sirayuri/SPCC_BLDC/report/report.tex

% !TeX program = lualatex
\documentclass[twocolumn, a4paper, 10pt, fleqn]{ltjsarticle}

% --- パッケージ ---
\usepackage{luatexja-fontspec} % フォント設定用
\usepackage[top=20mm, bottom=20mm, left=18mm, right=18mm]{geometry}
\usepackage{graphicx}
\usepackage{amsmath,amssymb}
\usepackage{url}
\usepackage{here}
% \usepackage{flushend}
\usepackage{booktabs} % 表の罫線を太く・美しくする

% --- フォント設定 (LuaLaTeX用) ---
\usepackage{luatexja-fontspec} % これが必要

\usepackage{subcaption}
\captionsetup{compatibility=false} % ltjsarticleとの相性問題を回避するおまじない

% メインの日本語フォント（明朝）を設定
% BoldFont = MS Gothic とすることで、太字の時だけゴシックに切り替わる
\setmainjfont[
    BoldFont = MS Gothic
]{MS Mincho}

% \sffamily (サンセリフ体) も念のためMSゴシックにしておく
\setsansjfont{MS Gothic}

% --- レイアウト設定 ---
\setlength{\columnsep}{10mm}

% --- フォント設定（ここが重要） ---
% 1. 本文（メイン）の設定 -> 明朝 & Century
\setmainfont{Century}
\setmainjfont{MS Mincho}

% 2. ゴシック体・サンセリフの設定 -> MSゴシック & Arial
% ltjsarticleは、章タイトルに自動的にこの「サンセリフ/ゴシック」を使う仕様になっている
\setsansfont{Arial}
\setsansjfont{MS Gothic}

\usepackage{caption}

% labelsep = quad  --> コロンを消して「1文字分の空白(\quad)」を入れる
% labelsep = space --> コロンを消して「半角スペース」を入れる
\captionsetup{font=sf, labelsep=quad}

% --- タイトル情報 ---
\title{
    \vspace{-8.5mm} % ← ここ！ 数値はプレビュー見ながら調整して（-15mmとか）
    \sffamily 
    % タイトル：14pt (Word基準) / 行間 20pt くらいにしておく
    \fontsize{14bp}{20bp}\selectfont 
    SPCCを用いたブラシレスモーターの設計試作とトルク測定 \\[2mm]
    
    % 英語タイトル：少し小さくする指定がなければそのままでいいけど、一応12ptとかにする？
    \fontsize{14bp}{20bp}\selectfont 
    Design, Fabrication, and Torque Analysis of a Brushless DC Motor Using SPCC
}
\author{
\parbox{\textwidth}{% 1. ページ幅いっぱいの箱を作る
        \hfill % 2. これで中身を全力で右に押しやる
        % 3. ここに「左揃え(l)」の表を作る
        % @{} は表の左右の余計な隙間を消すおまじない
        \fontsize{10bp}{15bp}\selectfont
        \begin{tabular}{@{}l@{}} 
            ◯渡辺敦也(鳥羽商船高等専門学校，Atsuya WATANABE)※\\
            　児玉謙司(鳥羽商船高等専門学校，Kenji KODAMA)\\
            　宮崎孝(鳥羽商船高等専門学校，Takashi MIYAZAKI)
        \end{tabular}
    }%
}
\date{}

% --- 章・節タイトルの強制変更 (ゴシック10pt) ---
\makeatletter
% \section (1. はじめに) の設定
\renewcommand{\section}{\@startsection{section}{1}{\z@}%
    {1.0\Cvs \@plus.5\Cvs \@minus.2\Cvs}% 前の行間（少し狭めた）
    {.5\Cvs \@plus.3\Cvs}% 後の行間
    {\normalfont\sffamily\fontsize{10bp}{15bp}\selectfont}% ゴシック(sffamily) + 10pt
}

% --- 参考文献のスタイル変更 ---
% 1. リストの番号を [1] から 1) に変更
\renewcommand{\@biblabel}[1]{#1)}

\newcommand{\figref}[1]{\textsf{図\ref{#1}}}
\newcommand{\tabref}[1]{\textsf{表\ref{#1}}}

% 2. 本文中の参照（\cite）を右上の「1)」に変更
% もし「右上の小さい文字」にしたくない場合は \textsuperscript を外してね
\renewcommand{\@cite}[1]{\textsuperscript{#1)}}

% \subsection (2.1 実験方法) の設定
\renewcommand{\subsection}{\@startsection{subsection}{2}{\z@}%
    {1.0\Cvs \@plus.5\Cvs \@minus.2\Cvs}%
    {.5\Cvs \@plus.3\Cvs}%
    {\normalfont\sffamily\fontsize{10bp}{15bp}\selectfont}% ゴシック + 10pt
}
\makeatother

\makeatletter % ← これがないとエラーになるから絶対入れて！
\newcommand\blfootnote[1]{%
    \begingroup
    \renewcommand\thefootnote{}%
    % ▼ ここがポイント！
    % 「番号を入れるための枠」を破壊して、強制的に左詰め(\noindent)にする
    \renewcommand\@makefntext[1]{\noindent ##1}% 
    \footnote{#1}%
    \addtocounter{footnote}{-1}%
    \endgroup
}
\makeatother % ← これも忘れずに！

\pagestyle{empty} % ページ番号を消す（フッター領域も消える）
\linespread{0.85}
% --- 数式の左インデント設定 ---
% 3\zw = 全角文字(Zenkaku Width) 3つ分
\setlength{\mathindent}{3\zw}

\renewcommand{\footnotesize}{%  
    \fontsize{7.5bp}{10bp}\selectfont % 文字8pt / 行送り10pt
}
% --- 脚注の上の線をカラム幅いっぱいにする ---
\renewcommand{\footnoterule}{%
    \kern-3pt % 少し上に移動（デフォルト値）
    \hrule width \columnwidth height 0.4pt % 幅を段の幅(\columnwidth)にする
    \kern 2.6pt % 元の位置に戻す（デフォルト値）
}

% --- 本文開始 ---
\begin{document}

\maketitle

\blfootnote{日本設計工学会東海支部令和7年度研究発表講演会(2026年2月28日)}

% ▼ ここにマイナスのスペースを入れる！
% 数値はフォントサイズによるけど、だいたい -5mm ～ -8mm くらいで合うはず
\vspace{-7mm}

% ここから2段組
\section{はじめに}
近年，ロボット業界でブラシレスDCモーター(以下，BLDCモーター)を用いたアクチュエータの需要が高まっている．しかし，個人が日本国内で購入可能なBLDCモーターに限定すると選択肢が狭まり，使用用途に対してトルク・回転数等が要求仕様を大きく上回っていたり，サイズが合わない等の問題が起きる．\\
　このことから，プロジェクトに合った性能・サイズを持つBLDCモーターの製作が要求される．
ここで課題となるのが，ステータの材料である．一般的なBLDCモーターでは残留磁化・保磁力が極めて低く，高透磁率・低鉄損である電磁鋼板を用いることが多いが，小ロットでの入手が困難である．
本研究では性能では電磁鋼板には劣るものの，小ロットを安価に入手可能な材料であるSPCC(冷延鋼板)を用いてBLDCモーターのステータを設計・試作し，トルクを測定することで実用性を評価する．

\section{BLDCモーターの設計}
BLDCモーターには主にロータがコイルより内側にあるインナーロータ方式と，コイルより外側にあるアウターロータ方式の2種類が存在する．ロボット業界では出力トルクが大きいことや，関節に用いやすい形状であることから後者の方が需要が高い．
本研究では製作難易度とロボット業界での需要を踏まえ，アウターロータ方式のBLDCモーターを採用し，SolidWorksを用いて設計した．
設計したBLDCモーターの全体像を\textgt{\figref{fig:BLDC_all}}に示す．
\begin{figure}[H]
    \centering
    % --- (a) 左側の図 ---
    \begin{subfigure}[b]{0.48\linewidth}
        \centering
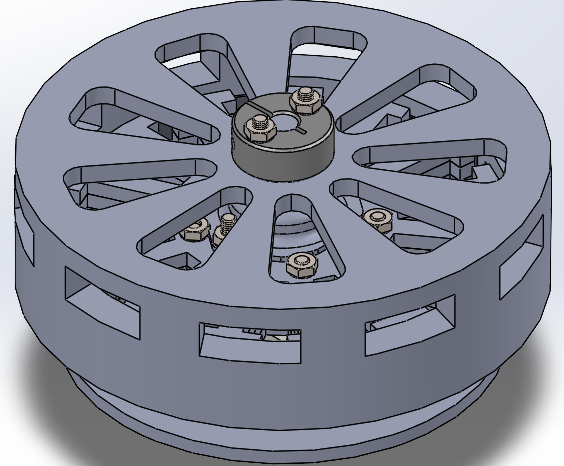
[picture p1: report/figure/BLDC_2.png]
        
        \caption{ロータ側}
        \label{fig:BLDC_top}
    \end{subfigure}
    \hfill % 左右の間隔を空ける
    % --- (b) 右側の図 ---
    \begin{subfigure}[b]{0.48\linewidth}
        \centering
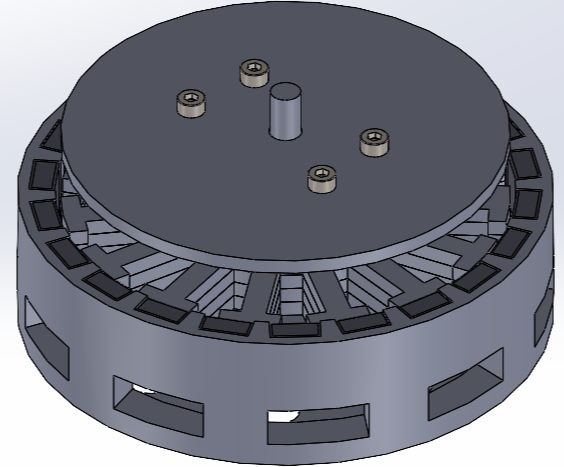
[picture p2: report/figure/BLDC_1.png]
        
        \caption{ステータ固定側}
        \label{fig:BLDC_bottom}
    \end{subfigure}
    % --- 全体のキャプション ---
    \caption{設計したBLDCモーター}
    \label{fig:BLDC_all}
\end{figure}

\vspace{-7mm}
\subsection{ステータの設計}
\vspace{-3mm}
ロボットアームやドローン用途に用いられる市販のアウターロータ方式のBLDCモーターの形状を参考に設計した．
これまでの検討では六角穴付きボルトを用いた9スロットのステータを設計したが，コギングトルクが非常に大きく，精密な制御が困難であった．スロット数を15に増やし，
材質を六角穴付きボルトの材質であるSCM435(クロムモリブデン鋼)からより軟磁性体に近いSPCC(冷延鋼板)に変更することでコギングトルクの低減が期待できる．\\
　SPCCをレーザー加工機で切り出し，断面を絶縁し4枚を重ね合わせ接着することで外径$88 \mathrm{mm}$のステータを構成する．このとき，レーザー加工機の加工限界を考慮し，厚さ3.2mmの薄板を用いる．
複数枚をそれぞれ絶縁して組み合わせることで，ステータ内部で発生する渦電流をある程度低減させ，発熱を抑える効果が多少期待できる．\\
　設計したステータを\textgt{\figref{fig:stater}}に示す．
\begin{figure}[H] % [tb]は「上(top)か下(bottom)に配置しろ」という指定
    \centering     % 図を中央寄せ
    % ▼ ここで画像を指定。[width=\linewidth]で段の幅ピッタリになる
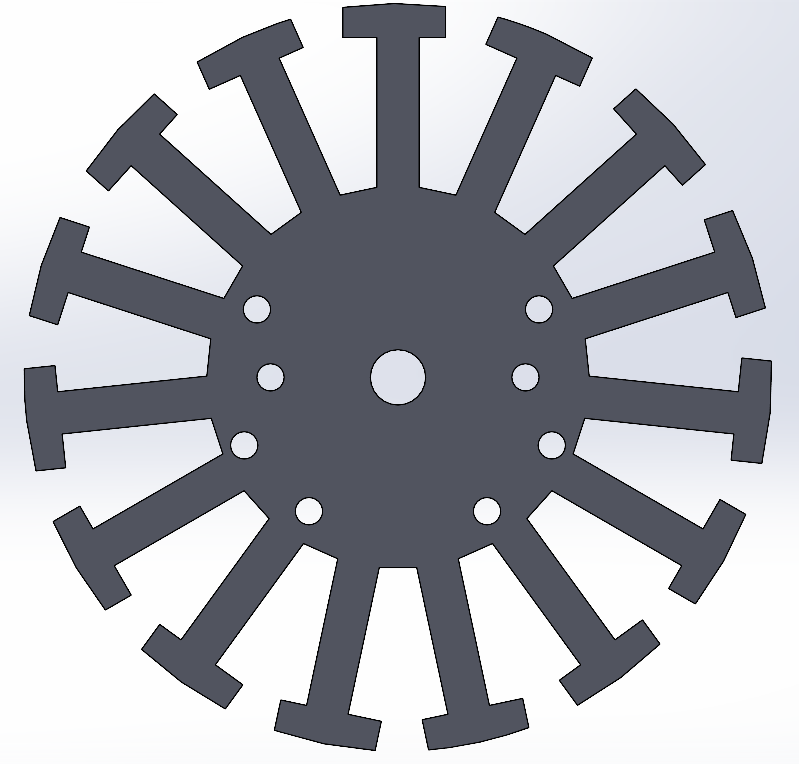
[picture p3: report/figure/stater.png]
     
    \caption{設計したステータ} % キャプションは図の下が一般的
    \label{fig:stater}            % 本文で参照するためのラベル
\end{figure}

\vspace{-7mm}
\subsection{ロータの設計}
\vspace{-3mm}
$12 \times 10 \times 5 \, (\mathrm{mm})$，表面磁束密度$B_{surf}$が$370(\mathrm{mT})$であるネオジム磁石を用いた外径$105 \mathrm{mm}$，内径$90 \mathrm{mm}$，極数22極のロータを設計した．
極数とスロット数の最小公倍数(LCM)は330であり，十分大きいため，コギングトルクの低減，出力トルクの向上が期待できる．\\
　ロータの慣性モーメントはBLDCモーターの性能に大きく影響を与える．ロータの材質をPLAとし，3Dプリンタで製造することで，質量を小さくし，慣性モーメントの低減を図る．\\
　アウターロータ方式のBLDCモーターは外部から空気が流入しないため，内部のコイルとステータの発熱が顕著になるという欠点がある．ロータに空気の流入口を設けることで冷却効果が期待できるよう設計した．\\
　設計したロータを\textgt{\figref{fig:rotor}}に示す．
\begin{figure}[H] % [tb]は「上(top)か下(bottom)に配置しろ」という指定
    \centering     % 図を中央寄せ
    % ▼ ここで画像を指定。[width=\linewidth]で段の幅ピッタリになる
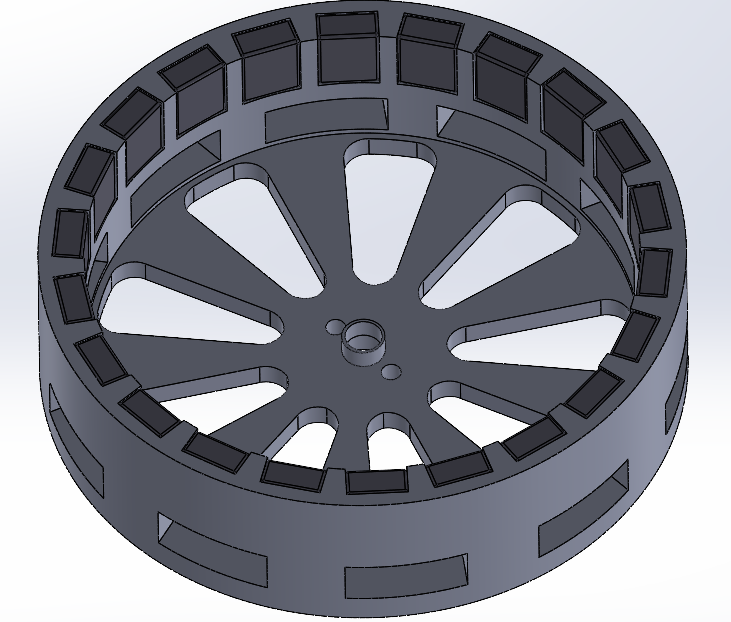
[picture p4: report/figure/rotor.png]
     
    \caption{設計したロータ} % キャプションは図の下が一般的
    \label{fig:rotor}            % 本文で参照するためのラベル
\end{figure}

\vspace{-7mm}
\section{トルクの推定}
\vspace{-3.5mm}
設計したBLDCモーターのトルクを計算して推定することで，理論値と実測値の乖離がどの程度大きくなるかを知ることができ，今後の設計に応用できる．
理論式を述べた後，各パラメータを代入してトルクを概算する．

\vspace{-5mm}
\subsection{トルクの理論式}
\vspace{-5.5mm}
表面磁石型のBLDCモーターのトルクの理論値を求める式は，極対数$P_n$，磁石による鎖交磁束$\Psi_a(\mathrm{Wb})$，磁石の作る磁束に直交する磁束を作る電流$I_q(\mathrm{A})$を用いると，次式で与えられる．
\begin{equation}
    T = \frac{3}{2} \cdot P_n \cdot \Psi_a \cdot I_q \label{eq:T_theoretical}
\end{equation}
この時，$\Psi_a(\mathrm{Wb})$は1スロットあたりのコイルの巻数$N$，巻線係数$k_w$，1極あたりのエアギャップの磁束密度$B_g(\mathrm{T})$，磁石の面積$S_g(\mathrm{m^2})$を用いて次式となる
\begin{equation}
    \Psi_a = N \cdot k_w \cdot B_g \cdot S_g \label{eq:Psi_a_theoretical}
\end{equation}
$B_g(\mathrm{T})$は磁石の残留磁束密度$B_r(\mathrm{T})$，エアギャップの距離$l_g(\mathrm{m})$，磁石の透磁率$\mu_r$，磁石の厚さ$l_m(\mathrm{m})$を用いて次式で表される
\begin{equation}
    B_g = \frac{B_r}{1+\frac{l_g \cdot \mu_r}{l_m}} \label{eq:B_g_theoretical}
\end{equation}

\vspace{-1mm}
\subsection{トルクの概算}
\vspace{-5.5mm}
式(\ref{eq:T_theoretical}),(\ref{eq:Psi_a_theoretical}),(\ref{eq:B_g_theoretical})に\textgt{\tabref{tab:motor_params}}に示すパラメータを代入し計算を行った結果，
\begin{equation}
    T \thickapprox 0.1767 \, (\mathrm{N \cdot m})
\end{equation}
という計算結果を得た．これをトルクの理論値として採用し，今後の比較に用いる．

\begin{table}[H]
    \centering
    \caption{設計したモーターの各パラメータ} % ★表のキャプションは「上」！
    \label{tab:motor_params}
    % 列指定: c=中央揃え, l=左揃え, r=右揃え
    % ここでは 記号(中央) | 意味(左) | 値(右) | 単位(左) にしてみた
    \begin{tabular}{clrl}
        \toprule % 上の太線
        記号 & パラメータ & \multicolumn{1}{c}{値} & 単位 \\ 
        \midrule % 中の細線
        $P_n$      & 極対数                 & 11   & - \\
        $I_q$      & $q$軸電流              & 1.000 & $\mathrm{A}$ \\
        $N$        & 1スロットのコイルの巻数 & 100   & - \\
        $k_w$      & 巻線係数               & 0.900  & - \\
        $S_g$      & 磁石1つの表面積           & 120.0   & $\mathrm{mm^2}$ \\
        $B_r$      & 磁石の残留磁束密度      & 1.200  & $\mathrm{T}$ \\
        $l_g$      & エアギャップ長         & 1.000& $\mathrm{mm}$ \\
        $\mu_r$    & 磁石の透磁率           & 1.050 & - \\
        $l_m$      & 磁石の厚さ             & 5.000& $\mathrm{mm}$ \\
        \bottomrule % 下の太線
    \end{tabular}
\end{table}

\vspace{-3.5mm}
\section{トルクの測定}
製作したモーターのトルク測定を行う．
\subsection{測定方法1（無負荷）}
\vspace{-3mm}
既知の慣性モーメント$J$を持つロータの角加速度$\dot{\omega}$を測定し，運動方程式 $T = J \cdot \dot{\omega}$ よりトルクを算出する．回転数ごとの動的なトルク特性を取得可能である．
\subsection{測定方法2（負荷あり）}
\vspace{-3mm}
長さ$l$のアームを取り付け，一定電流下で質量$m$の錘と釣り合わせることで静止トルクを測定する（$T = m \cdot g \cdot l$）．

\section{終わりに}
SPCC(冷延鋼板)を用いたステータと，PLAを用いたロータを設計・試作した．
ステータは3.2mm厚の板を絶縁して積層することで渦電流による発熱を抑え，ロータは慣性モーメントを小さくするために3Dプリンタ製パーツを採用した．
理論計算によるトルク推定を行った結果，減速機なしで$0.1767(\mathrm{N \cdot m})$となり，理論上は実用に足る性能であることがわかった．
講演では，設計製作したBLDCモーターの始動トルク，連続出力トルク，連続運転時の温度上昇の測定結果と，実際に実用に足る性能であったかを発表する．

\begin{thebibliography}{99}
    \bibitem{motor_book} R．Krishnan， Permanent Magnet Synchronous and Brushless DC Motors, CRC Press (2010), pp.7--9
\end{thebibliography}

\end{document}
