sirayuri/SPCC_BLDC/table/table.pdf

表 1: 設計したモーターの各パラメータ

記号 パラメータ | 値 | 単位
Pn | 極対数 | 11 -
qs | スロット数 | 15 -
N | 1 スロットのコイルの巻数 | 40 -
kw | 巻線係数 (仮定) | 0.900 -
Sg | 磁石 1 つの表面積 | 120.0 mm²
Br | 磁石の残留磁束密度 | 1.182 T
lg | エアギャップ長 | 2.000 mm
µr | 磁石の透磁率 | 1.050 -
lm | 磁石の厚さ | 5.000 mm

1
