sirayuri/SPCC_BLDC/report/figure/BLDC_3.png

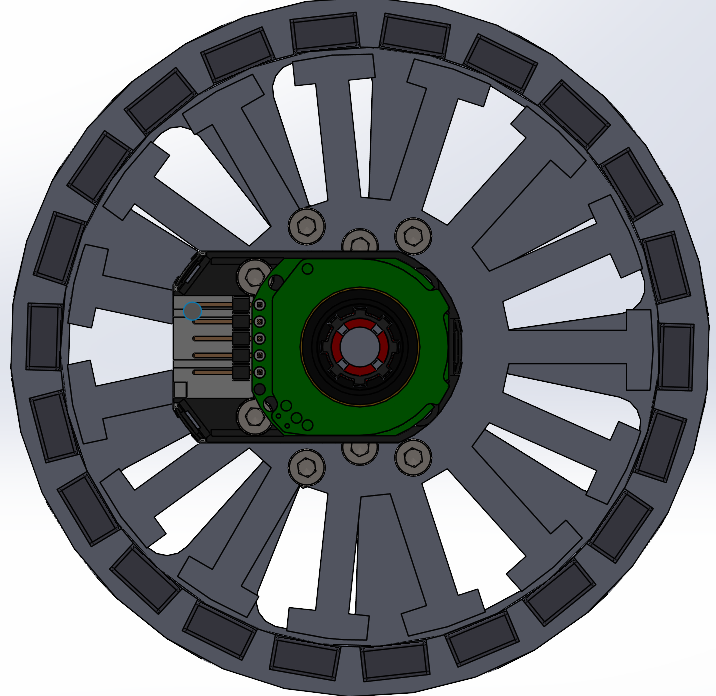
report/figure/BLDC_3.png
