sirayuri/SPCC_BLDC/report/figure/kiban.jpg

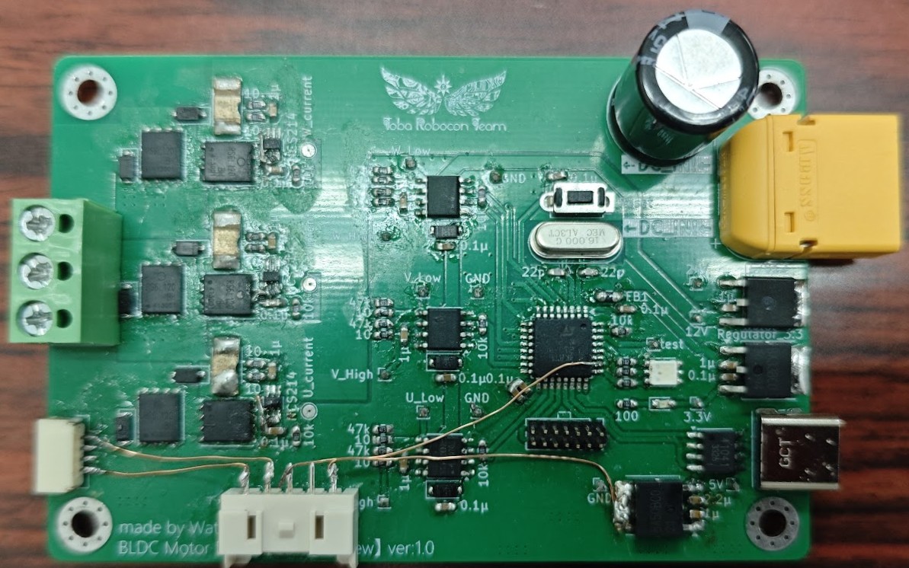
report/figure/kiban.jpg
