sirayuri/SPCC_BLDC/parts/Same_Sky_AMT10E2-0120-N6000-S/BOM.txt

3DX_Same_Sky_Supplier: Same Sky
3DX_Same_Sky_Description: AMT10E Series - 28 mm,  120 ~ 5120 PPR, Incremental, Capacitive Modular Encoder
3DX_Same_Sky_Model Number: AMT10E2-0120-N6000-S
