sirayuri/SPCC_BLDC/asen/rotor_next.SLDASM

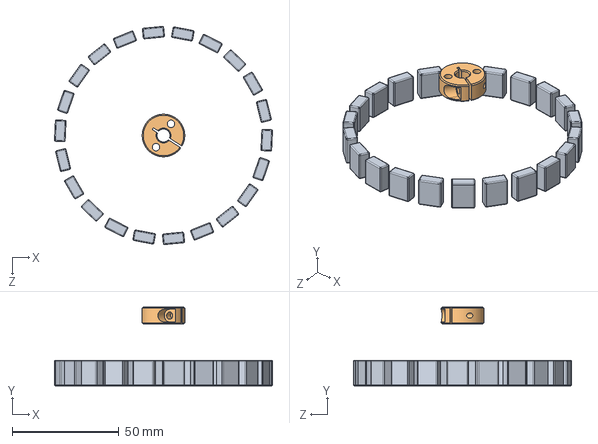
[picture p7: CAD file, 2026-03-08]
asen/rotor_next.SLDASM
102.3 x 37.0 x 102.4 mm
SCS 0608CP2-part
magnet x 22
