sirayuri/SPCC_BLDC/asen/main1.STEP

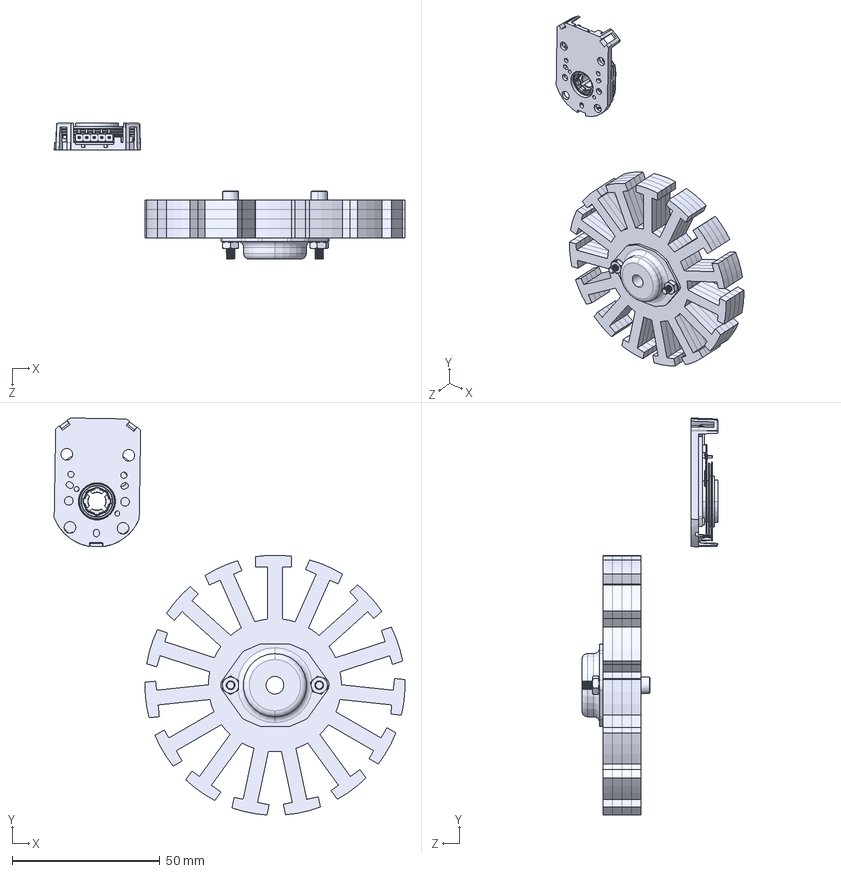
[picture p8: CAD file, 2026-02-08]
asen/main1.STEP
118.7 x 134.3 x 46.2 mm
3.2_stater x 4
6_bearing
AMT-102-Base-REV-K.step
AMT-102-Top-Cover-REV-I.step
AMT-Sleeve-REV-D_6 mm.step
AMT-Hub-Top-REV-D1.step
AMT-Hub-Bottom-REV-B.step
AMT10X-Shaft-Adaptor-REV-E.step
Receiver-board.step
Rotor-board-REV F.step
Transmitter-board AMT10_AMT-102.step
hexagon socket head cap screw_jis_JIS B 1176 M3 x 20 (20) --S x 2
hexagon nut style 1_ab_jis_JIS B 1181 Hexagon nut - style 1 A M3 - W --N x 2
