sirayuri/SPCC_BLDC/parts/IWATA_SCS0608CP2/SOLIDWORKS/SCS  0608CP2-part.sldprt

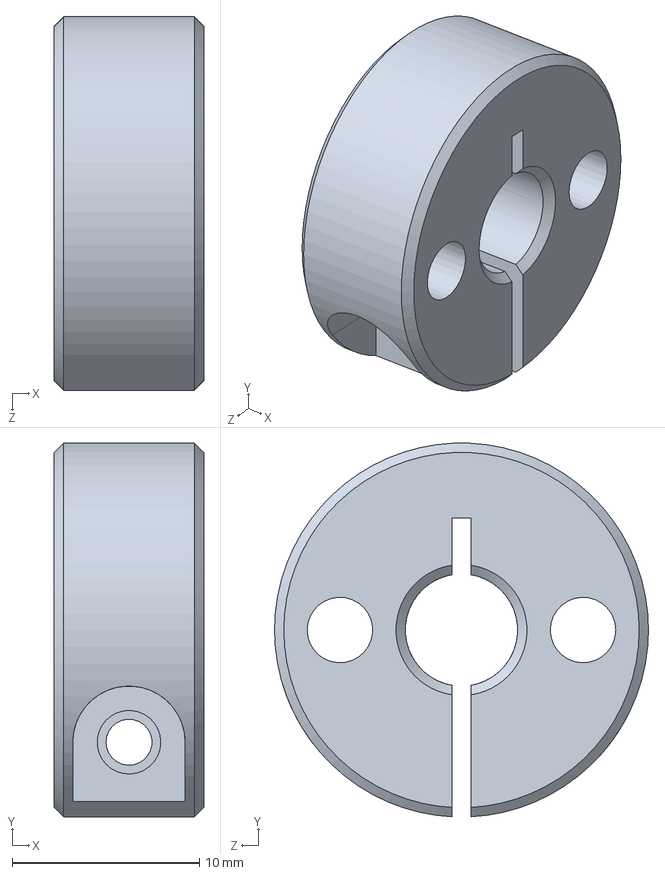
[picture p9: CAD file, 2026-02-24]
parts/IWATA_SCS0608CP2/SOLIDWORKS/SCS 0608CP2-part.sldprt
8.00 x 20.0 x 20.0 mm
