sirayuri/SPCC_BLDC/parts/Same_Sky_AMT10E2-0120-N6000-S/Same_Sky_AMT10E2-0120-N6000-S.step

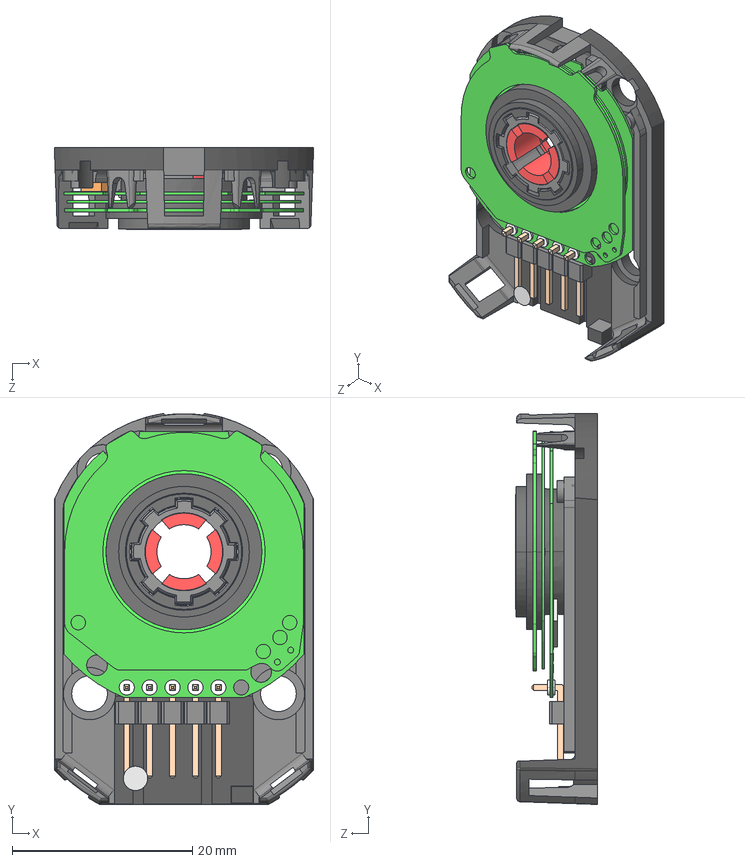
[picture p10: CAD file, 2026-02-08]
parts/Same_Sky_AMT10E2-0120-N6000-S/Same_Sky_AMT10E2-0120-N6000-S.step
28.8 x 43.4 x 9.15 mm
AMT-102-Base-REV-K
AMT-102-Top-Cover-REV-I
AMT-Sleeve-REV-D_6 mm
AMT-Hub-Top-REV-D1
AMT-Hub-Bottom-REV-B
AMT10X-Shaft-Adaptor-REV-E
Receiver-board
Rotor-board-REV F
Transmitter-board AMT10_AMT-102
