sirayuri/SPCC_BLDC/parts/Same_Sky_AMT10E2-D5120-N6000-W/Same_Sky_AMT10E2-D5120-N6000-W.step

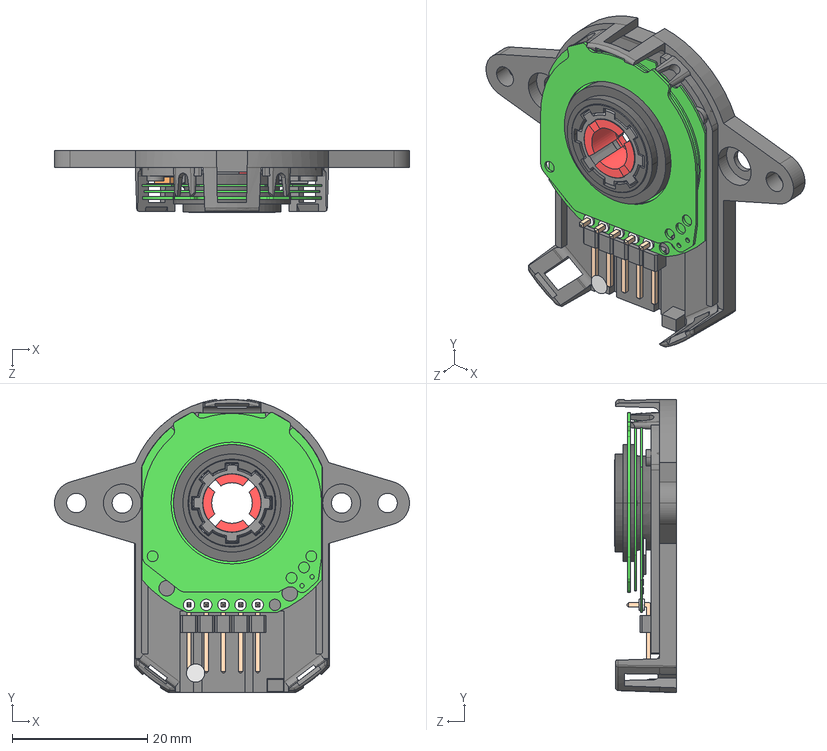
[picture p11: CAD file, 2026-02-07]
parts/Same_Sky_AMT10E2-D5120-N6000-W/Same_Sky_AMT10E2-D5120-N6000-W.step
52.5 x 43.4 x 9.15 mm
AMT-102-Top-Cover-REV-I
AMT-Sleeve-REV-D_6 mm
AMT-Hub-Top-REV-D1
AMT-Hub-Bottom-REV-B
AMT10X-Shaft-Adaptor-REV-E
Receiver-board
Rotor-board-REV F
Transmitter-board AMT10_AMT-102
AMT-102-Wide-Base-REV-J
