sirayuri/SPCC_BLDC/parts/ude.SLDPRT

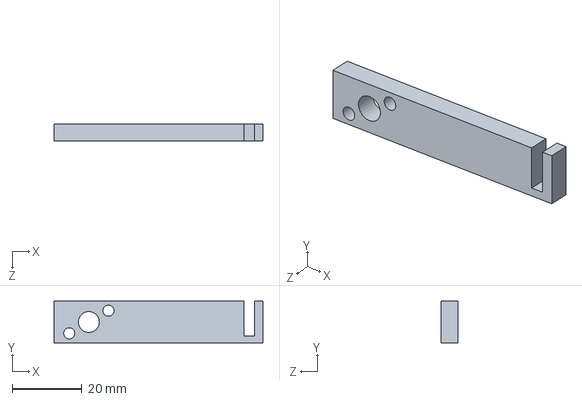
[picture p12: CAD file, 2026-03-08]
parts/ude.SLDPRT
60.0 x 12.0 x 5.00 mm
