sirayuri/SPCC_BLDC/parts/ziguzigu.SLDPRT

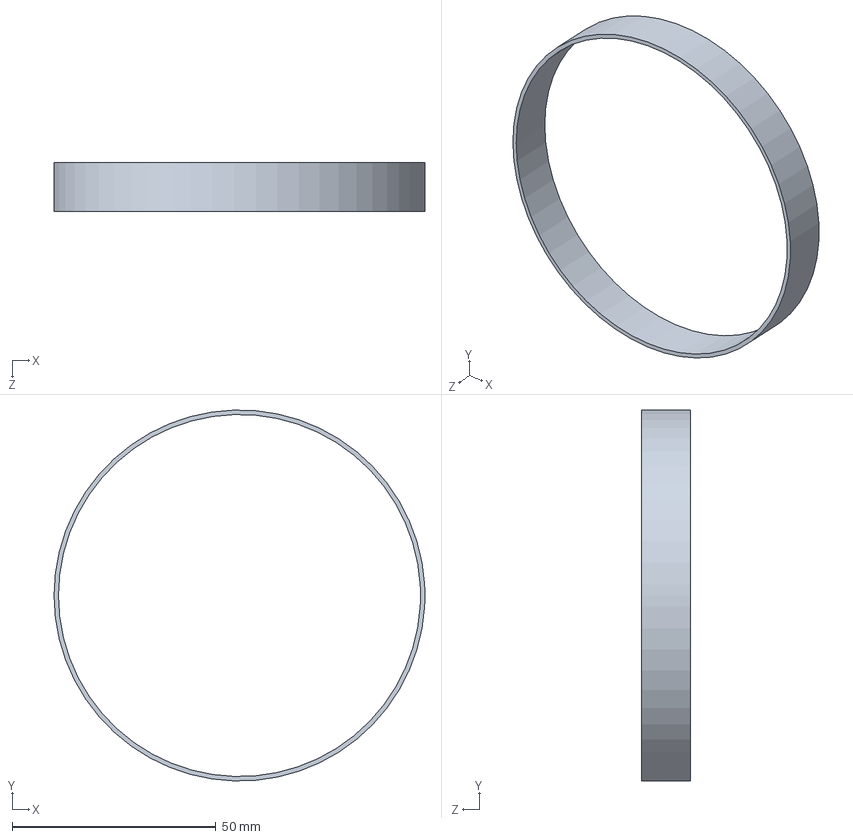
[picture p13: CAD file, 2026-02-27]
parts/ziguzigu.SLDPRT
91.0 x 91.0 x 12.0 mm
