sirayuri/SPCC_BLDC/parts/stater_cuber.STEP

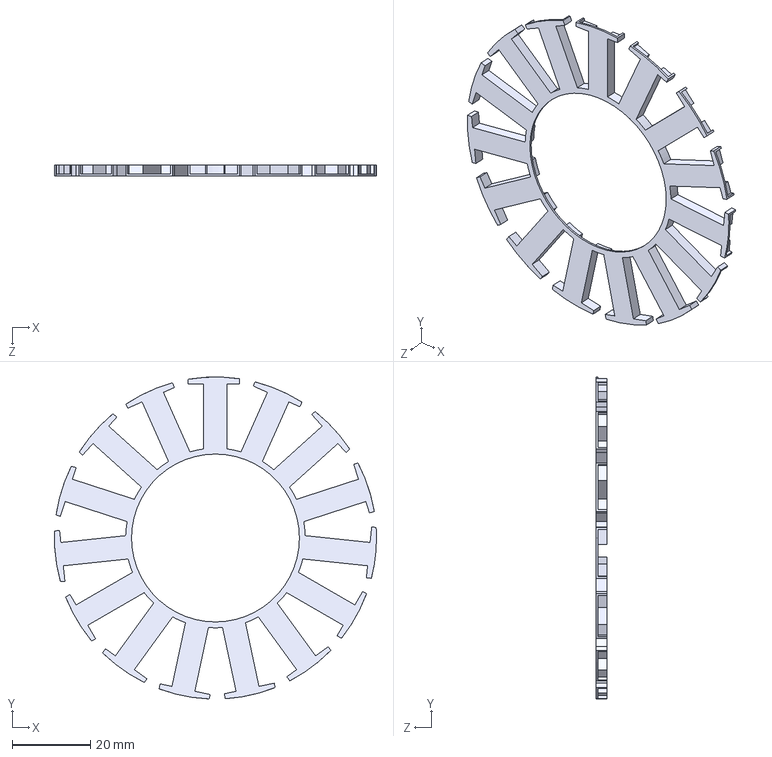
[picture p14: CAD file, 2026-02-23]
parts/stater_cuber.STEP
82.5 x 82.4 x 2.80 mm
