sirayuri/SPCC_BLDC/parts/roter_next_next_next.STEP

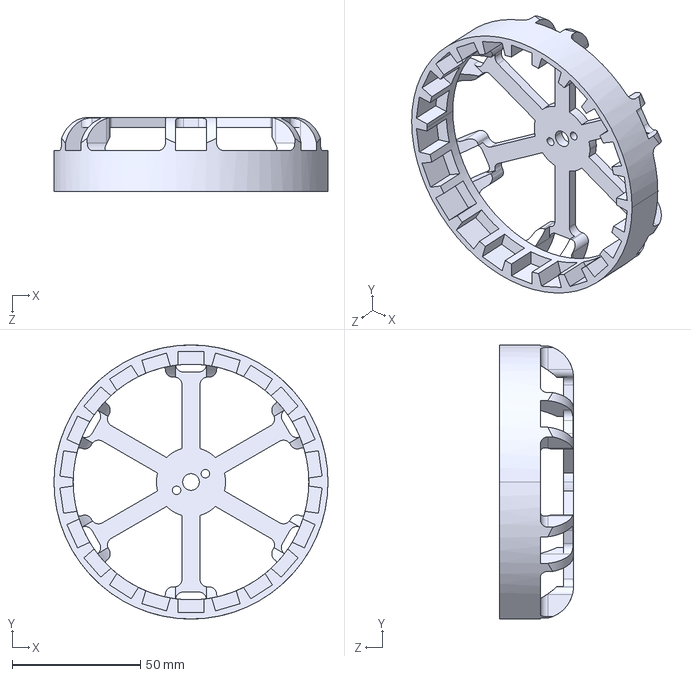
[picture p15: CAD file, 2026-02-23]
parts/roter_next_next_next.STEP
107.0 x 107.0 x 29.0 mm
