sirayuri/SPCC_BLDC/parts/tateruyatu.SLDPRT

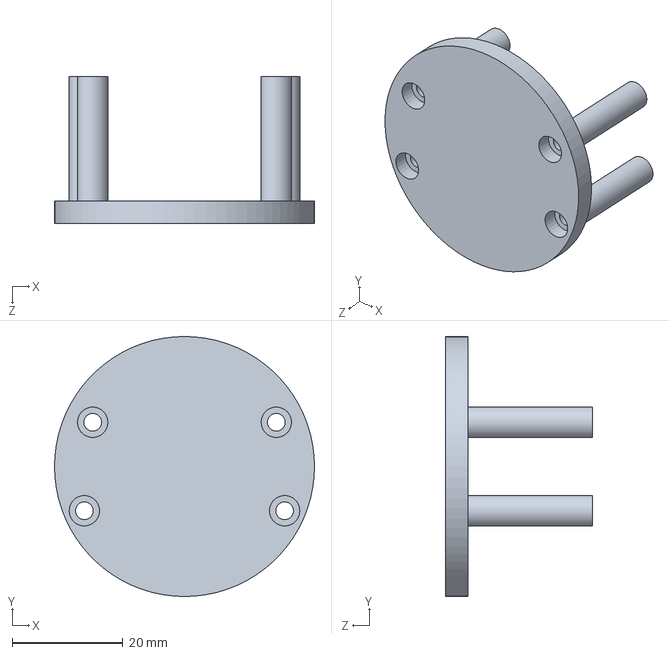
[picture p16: CAD file, 2026-02-23]
parts/tateruyatu.SLDPRT
47.0 x 47.0 x 26.5 mm
