sirayuri/SPCC_BLDC/parts/cuba-.SLDPRT

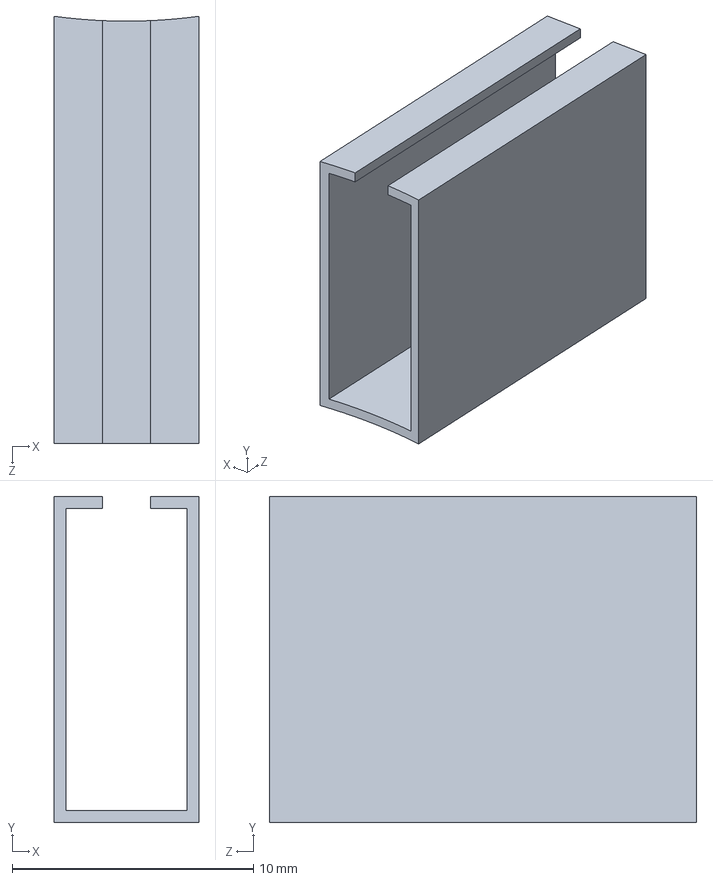
[picture p17: CAD file, 2026-02-23]
parts/cuba-.SLDPRT
6.00 x 13.5 x 17.7 mm
