sirayuri/SPCC_BLDC/parts/stater_cuber_ura.STEP

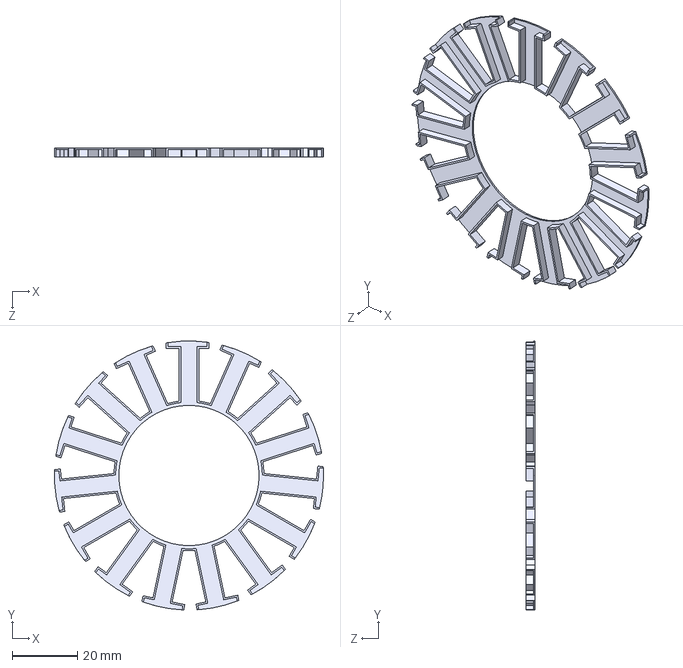
[picture p18: CAD file, 2026-02-23]
parts/stater_cuber_ura.STEP
82.5 x 82.4 x 2.80 mm
