sirayuri/SPCC_BLDC/parts/egusupacer.SLDPRT

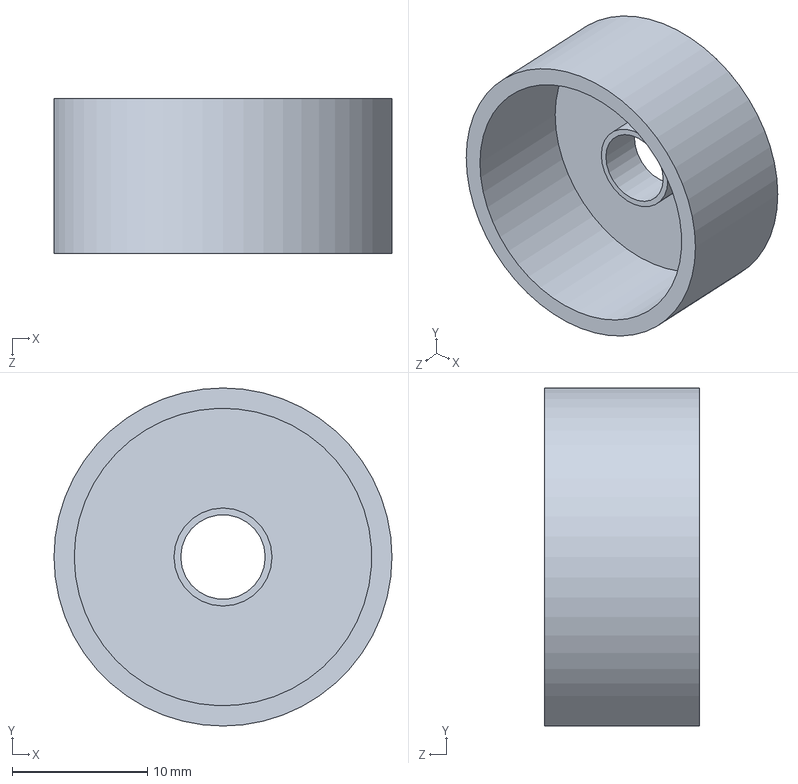
[picture p19: CAD file, 2026-02-19]
parts/egusupacer.SLDPRT
25.0 x 25.0 x 11.5 mm
