sirayuri/SPCC_BLDC/parts/tyouseiyou.SLDPRT

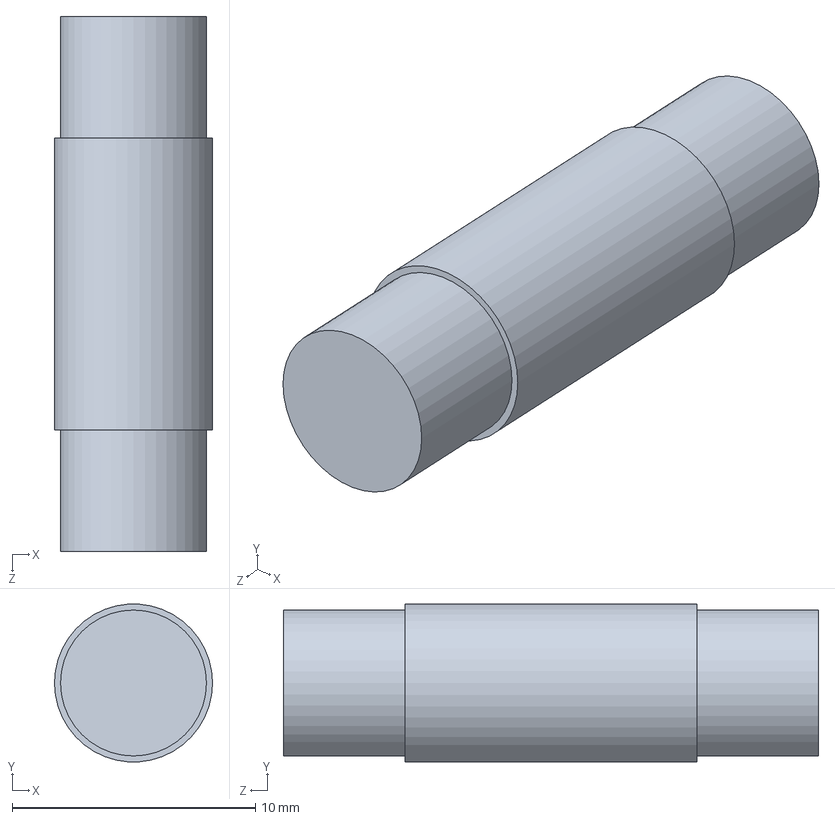
[picture p20: CAD file, 2026-02-19]
parts/tyouseiyou.SLDPRT
6.50 x 6.48 x 22.0 mm
