sirayuri/SPCC_BLDC/parts/saft_spacer.SLDPRT

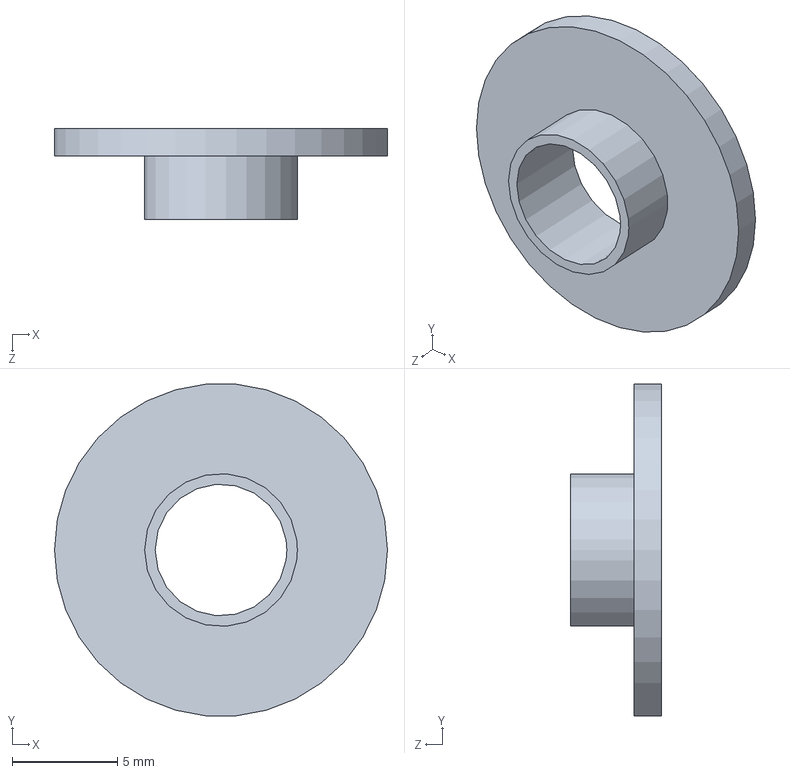
[picture p21: CAD file, 2026-02-18]
parts/saft_spacer.SLDPRT
15.8 x 15.7 x 4.30 mm
