sirayuri/SPCC_BLDC/parts/spacer_7.2.SLDPRT

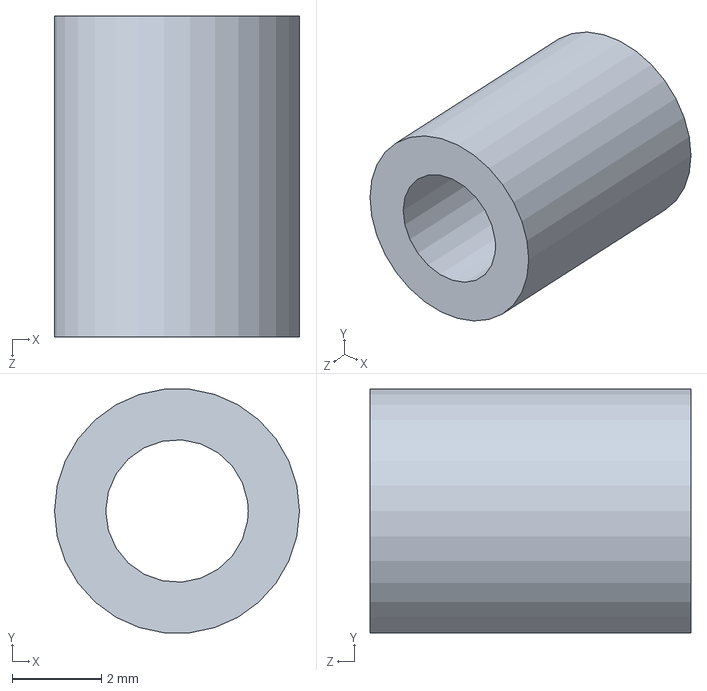
[picture p22: CAD file, 2026-02-18]
parts/spacer_7.2.SLDPRT
5.50 x 5.47 x 7.20 mm
