sirayuri/SPCC_BLDC/parts/spacer_16.2.SLDPRT

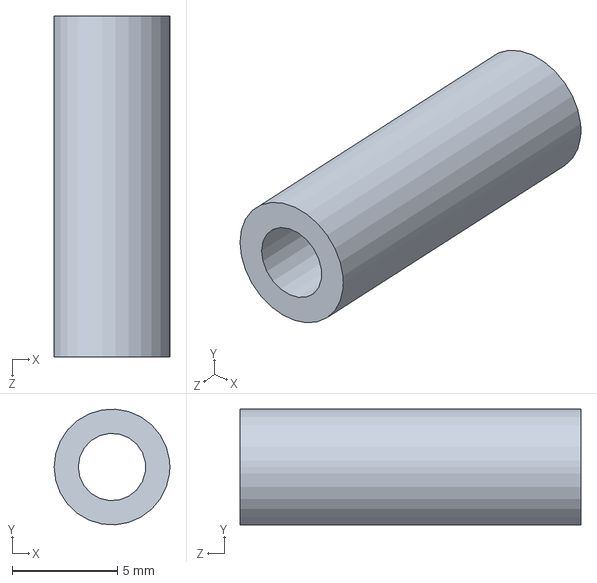
[picture p23: CAD file, 2026-02-18]
parts/spacer_16.2.SLDPRT
5.50 x 5.49 x 16.2 mm
