sirayuri/SPCC_BLDC/parts/hari.SLDPRT

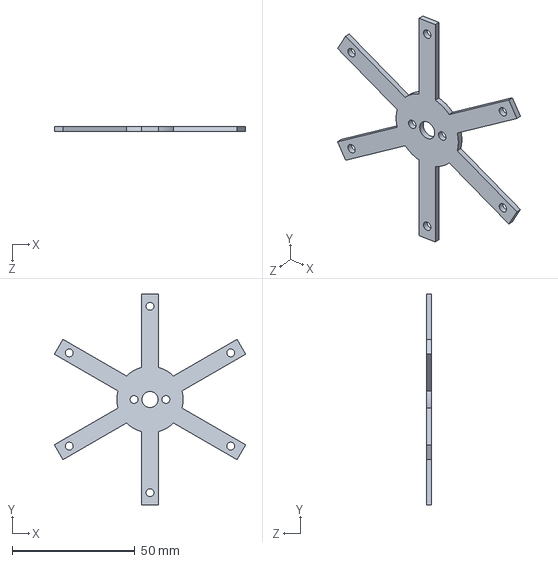
[picture p24: CAD file, 2026-02-18]
parts/hari.SLDPRT
77.9 x 85.9 x 2.00 mm
