sirayuri/SPCC_BLDC/parts/spacer_3_5.STEP

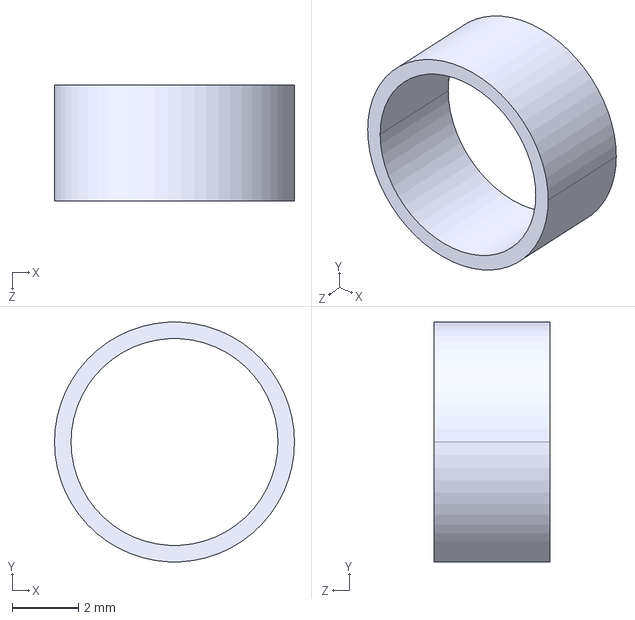
[picture p25: CAD file, 2026-02-17]
parts/spacer_3_5.STEP
7.25 x 7.24 x 3.50 mm
