sirayuri/SPCC_BLDC/parts/spacer_12.5.STEP

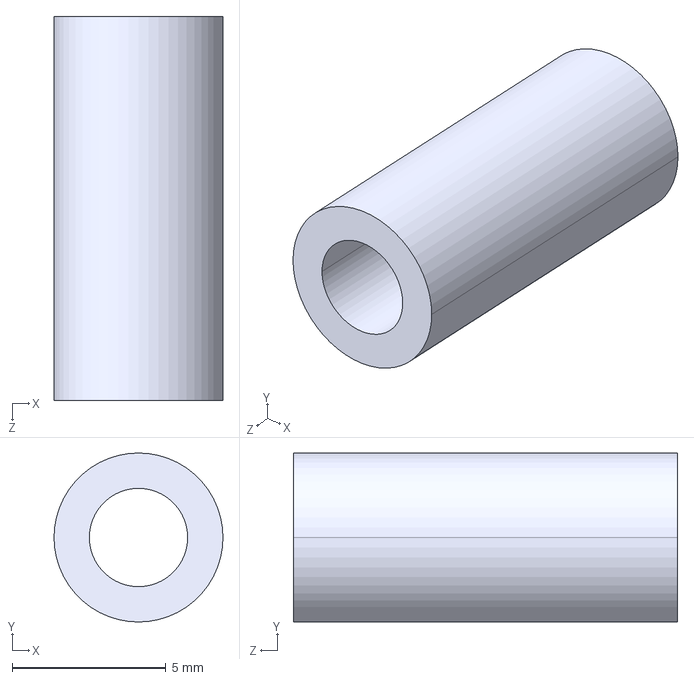
[picture p26: CAD file, 2026-02-17]
parts/spacer_12.5.STEP
5.50 x 5.50 x 12.5 mm
