sirayuri/SPCC_BLDC/parts/spacer_3.STEP

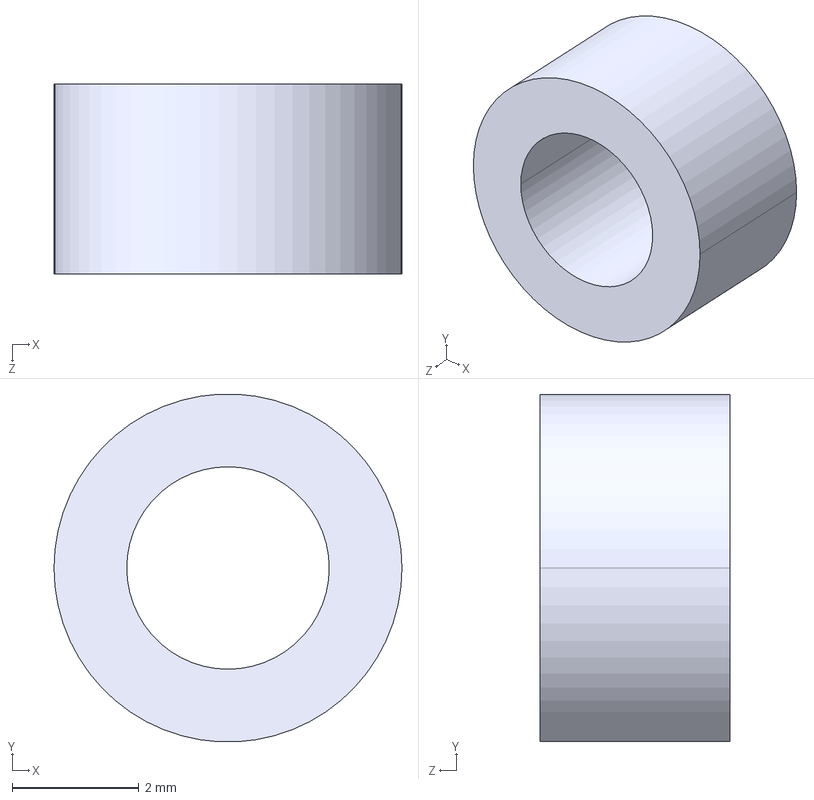
[picture p27: CAD file, 2026-02-17]
parts/spacer_3.STEP
5.50 x 5.49 x 3.00 mm
