sirayuri/SPCC_BLDC/parts/roter_next.STEP

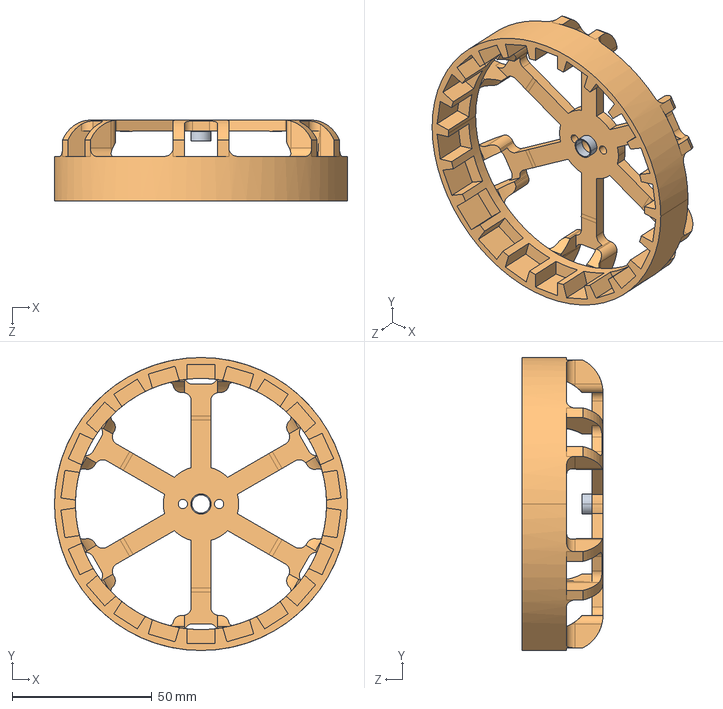
[picture p28: CAD file, 2026-02-15]
parts/roter_next.STEP
105.0 x 105.0 x 29.0 mm
