sirayuri/SPCC_BLDC/parts/magnet.SLDPRT

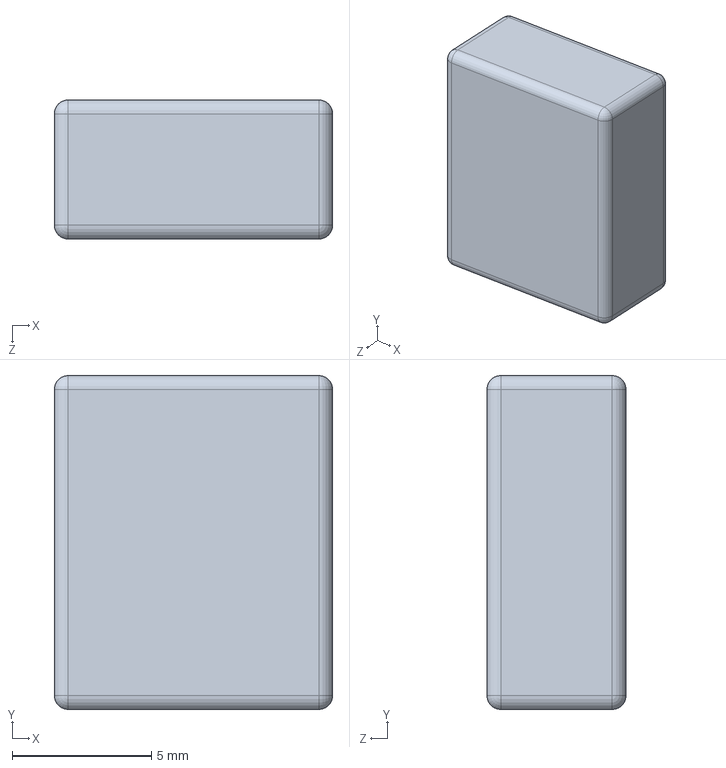
[picture p29: CAD file, 2026-02-15]
parts/magnet.SLDPRT
10.0 x 12.0 x 5.00 mm
