sirayuri/SPCC_BLDC/parts/plate.SLDPRT

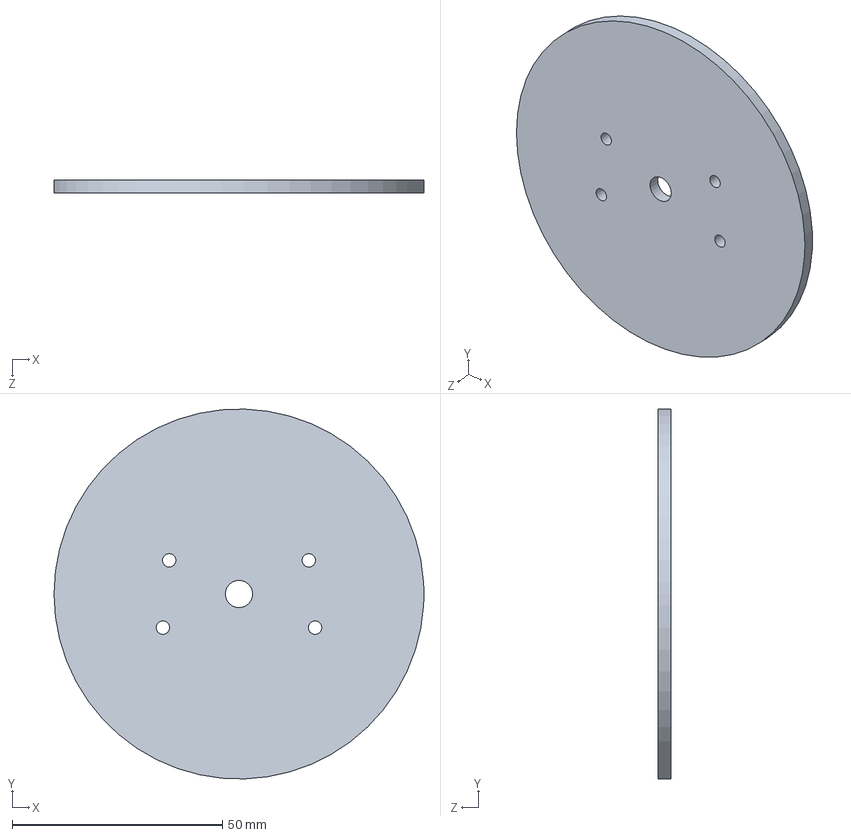
[picture p30: CAD file, 2026-02-15]
parts/plate.SLDPRT
88.0 x 88.0 x 3.00 mm
