sirayuri/SPCC_BLDC/parts/roter.STEP

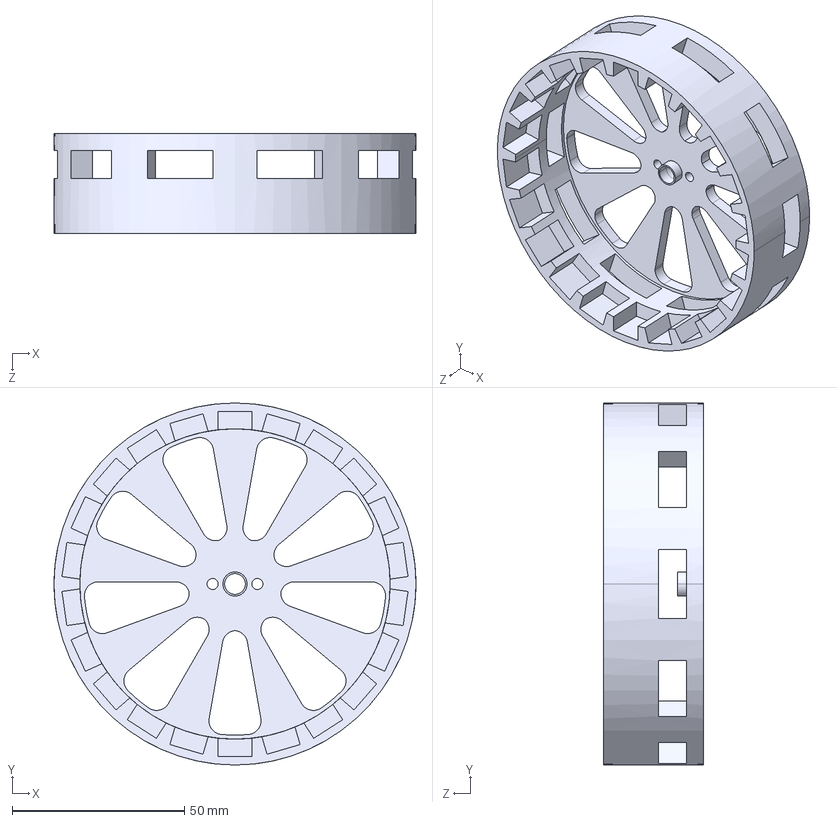
[picture p31: CAD file, 2026-02-11]
parts/roter.STEP
105.0 x 105.0 x 29.0 mm
