sirayuri/SPCC_BLDC/parts/shaft_6.STEP

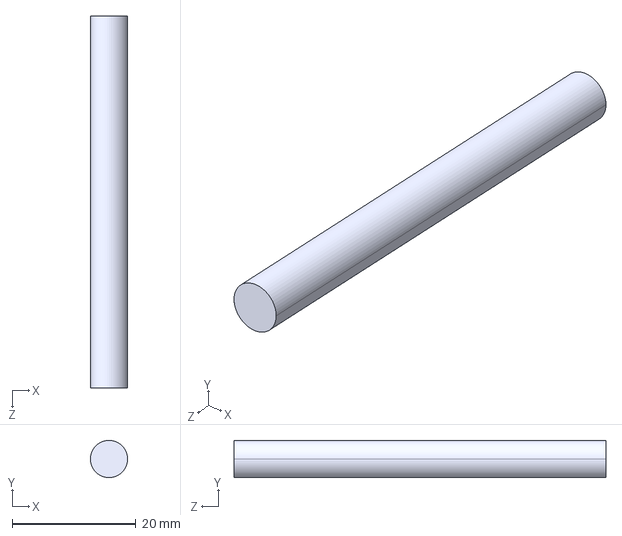
[picture p32: CAD file, 2026-02-08]
parts/shaft_6.STEP
6.00 x 6.00 x 60.0 mm
