sirayuri/SPCC_BLDC/parts/3.2_stater.STEP

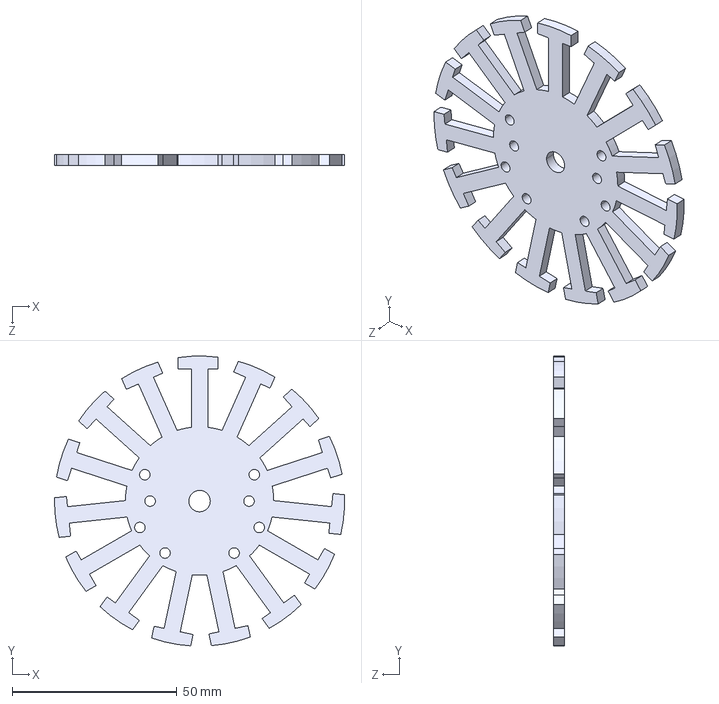
[picture p33: CAD file, 2026-02-08]
parts/3.2_stater.STEP
88.0 x 87.9 x 3.20 mm
