sirayuri/SPCC_BLDC/parts/6_bearing.SLDPRT

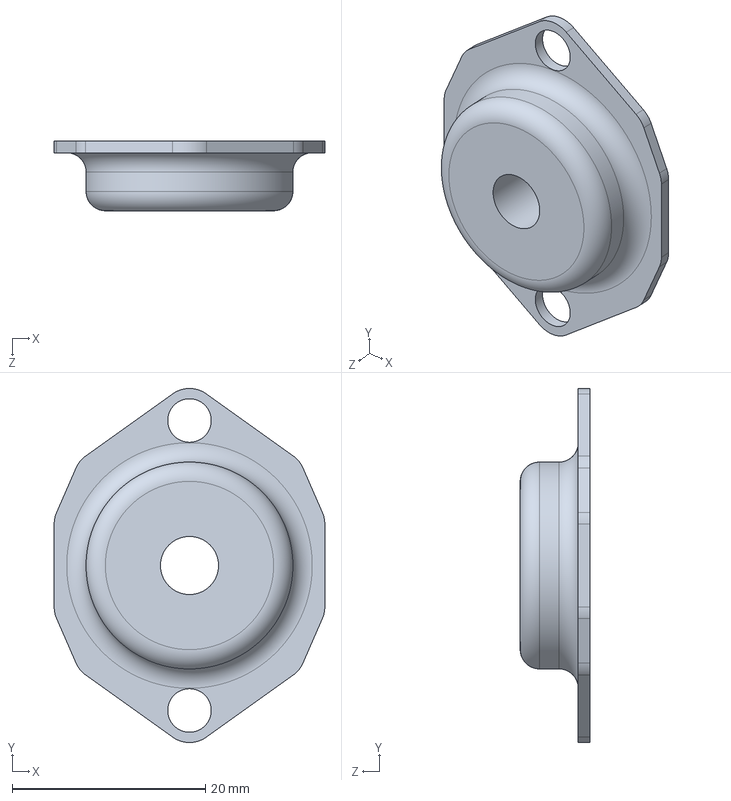
[picture p34: CAD file, 2026-02-07]
parts/6_bearing.SLDPRT
28.0 x 36.6 x 7.20 mm
