sirayuri/SPCC_BLDC/asen/rotor.SLDASM

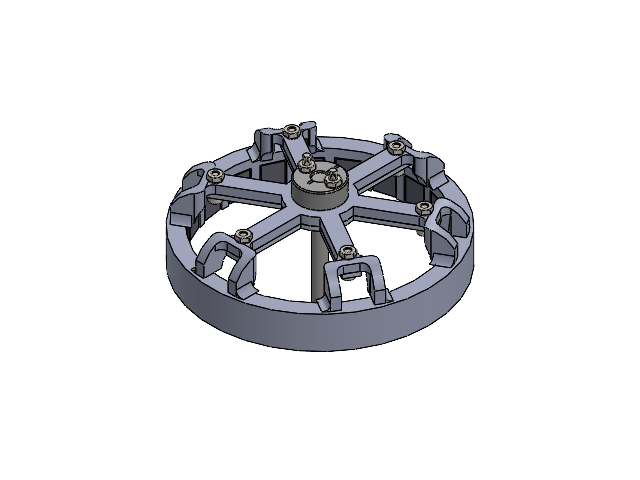
[picture p35: CAD file, 2026-02-23]
asen/rotor.SLDASM
roter_next_next
magnet x 22
SCS 0608CP2-part
shaft_6
hari
hexagon socket head cap screw_jis x 8
hexagon nut style 1_ab_jis x 8
