sirayuri/SPCC_BLDC/asen/stater.SLDASM

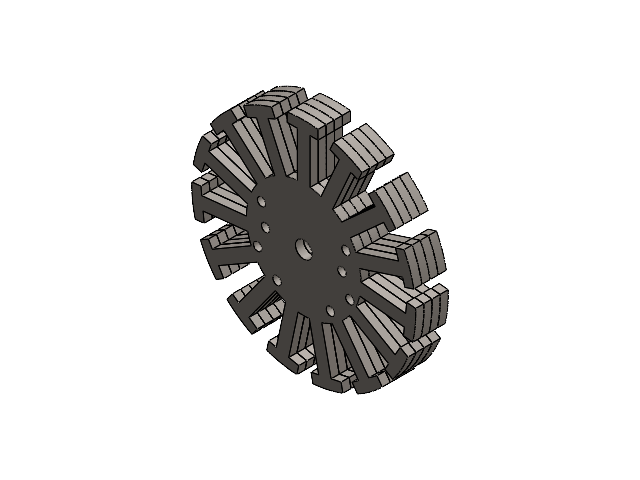
[picture p36: CAD file, 2026-02-17]
asen/stater.SLDASM
3.2_stater x 4
