sirayuri/SPCC_BLDC/(list of files, cad)

Other CAD files:
parts/IWATA_SCS0608CP2/SOLIDWORKS/SCS0608CP2.sldasm
parts/roter_next_next.SLDPRT
3.2_stater.3mf
3.2_stater.STEP
asen/main1.SLDASM
parts/3.2_stater.DXF
parts/3.2_stater.SLDPRT
parts/cuba-.STL
parts/egusupacer.STL
parts/hexagon socket head cap screw_jis.SLDPRT
parts/roter.3mf
parts/roter.SLDPRT
parts/roter_next.SLDPRT
parts/roter_next_next.STL
parts/roter_next_next_next.SLDPRT
parts/saft_spacer.STL
parts/shaft_6.SLDPRT
parts/spacer_12.5.SLDPRT
parts/spacer_3.3mf
parts/spacer_3.SLDPRT
parts/spacer_3_5.SLDPRT
parts/spacer_7.2.STL
parts/stater_cuber.3mf
parts/stater_cuber.SLDPRT
parts/stater_cuber_ura.SLDPRT
parts/tateruyatu.3mf
parts/tateruyatu.STL
parts/tyouseiyou.STL
parts/ude.STL
parts/ziguzigu.STL
