sirayuri/SPCC_BLDC/programs/SPCC_BLDC_FOC_dq_FF/Core/Src/main.c

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
/* Includes ------------------------------------------------------------------*/
#include "main.h"

/* USER CODE BEGIN Includes */

#include <stdio.h>
#include <math.h>
#include <stdbool.h>

/* USER CODE END Includes */

/* USER CODE BEGIN PTD */

typedef struct{
	float kp;
	float ki;
	float goal;
	float now_value;
	float error;
	float error_integral;
	float error_integral_temp;
	float integral_limit;
}PI_t;

typedef struct{
	float kp;
	float ki;
	float kd;
	float goal;
	float now_value;
	float error;
	float error_old;
	float error_integral;
	float error_integral_temp;
	float integral_limit;
}PID_t;

/* USER CODE END PTD */

/* USER CODE BEGIN PM */

//PWMの使用タイマ
#define MOTOR_PWM_TIMER htim3
//各チャンネル
#define U_PHASE_PWM_CHANNEL TIM_CHANNEL_3
#define V_PHASE_PWM_CHANNEL TIM_CHANNEL_2
#define W_PHASE_PWM_CHANNEL TIM_CHANNEL_1

//PWM出力関数
#define SET_PWM_DUTY(PHASE, DUTY) __HAL_TIM_SET_COMPARE(&MOTOR_PWM_TIMER, PHASE##_PHASE_PWM_CHANNEL, DUTY)

#define SQRT3_OVER_2 0.8660254f
#define ONE_OVER_SQRT3 0.57735026f
#define PI 3.1415f

/* USER CODE END PM */

ADC_HandleTypeDef hadc1;
DMA_HandleTypeDef hdma_adc1;

TIM_HandleTypeDef htim1;
TIM_HandleTypeDef htim2;
TIM_HandleTypeDef htim3;

UART_HandleTypeDef huart1;

/* USER CODE BEGIN PV */

/*	モーターの定数	*/
//極対数
int pole_pairs = 11;

/*	角度関係	*/
//現在のエンコーダーのカウント
uint16_t cnt_now = 0;

//1回前のエンコーダーのカウント
uint16_t cnt_old = 0;

//回転した回数
int revolution_count = 0;

//エンコーダーが1回のループでどれだけ回転したら1回転したとみなすかのしきい値
int revolution_threshold_num = 10000;

//現在のラジアン角
float degree = 0;

//現在のラジアン機械角
float degree_e = 0;

//機械角に対するsin,cos
float degree_e_sin = 0;
float degree_e_cos = 0;

/*	電流センシング関係	   */

//DMAから送られてくる生のDMAの値
volatile uint16_t adc_raw[3] = {0};

//モーター停止時の電流センサにかかるオフセット電圧
int adc_offset[3] = {0};

//オフセットの平均値の計算に使用
int offset_count = 0;
int offset_ave_num = 30;
volatile bool offset_done_flag = false;

//現在の電流値
volatile float I_u = 0;
volatile float I_v = 0;
volatile float I_w = 0;

//電流の総和
float I_sum = 0;

/* ベクトル制御用変数 */
//dq電流
float Id = 0.0;
float Iq = 0.0;

//αβ電流
float Ia = 0.0;
float Ib = 0.0;

//dq電圧
float Vd = 0.0;
float Vq = 0.0;

//αβ電圧
float Va = 0.0;
float Vb = 0.0;

//PWM
int U_PWM = 0;
int V_PWM = 0;
int W_PWM = 0;

int Amp_PWM_MAX = 300;

//PI制御用構造体
PI_t Id_PI;
PI_t Iq_PI;

volatile bool tim1_flag = false;
volatile bool tim3_flag = false;
volatile bool zero_set_flag = false;

//ログ用
#define LOG_SIZE 500
float dq_log[2][LOG_SIZE] = {0};
int log_index = 0;
int log_prescaler = 0;
volatile bool logging_active = false;


/*	位置PID用変数	*/
PID_t Place_PID;

float test_theta = 0.0;

/* USER CODE END PV */

void SystemClock_Config(void);
static void MX_GPIO_Init(void);
static void MX_DMA_Init(void);
static void MX_ADC1_Init(void);
static void MX_TIM3_Init(void);
static void MX_USART1_UART_Init(void);
static void MX_TIM2_Init(void);
static void MX_TIM1_Init(void);
/* USER CODE BEGIN PFP */
int constrain(int num, int min, int max);
float constrainf(float num, float min, float max);
int _write(int file, char *ptr, int len);
void clarke_transform(void);
void park_transform(void);
void inv_clarke_transform(void);
void inv_park_transform(void);
float PI_Control(PI_t *hPI);
/* USER CODE END PFP */

/* USER CODE BEGIN 0 */

int constrain(int num, int min, int max){
	if(num > max){
		return max;
	}
	else if(min > num){
		return min;
	}
	else{
		return num;
	}
}

float constrainf(float num, float min, float max){
	if(num > max){
		return max;
	}
	else if(min > num){
		return min;
	}
	else{
		return num;
	}
}

//printfおまじない
int _write(int file, char *ptr, int len)
{
  HAL_UART_Transmit(&huart1,(uint8_t *)ptr,len,10);
  return len;
}

void HAL_TIM_PeriodElapsedCallback(TIM_HandleTypeDef *htim)
{
    if(htim == &htim1){
    	tim1_flag = true;
    }

    if(htim == &htim3){
    	tim3_flag = true;
    }
}

//ADCのDAM割り込み！
void HAL_ADC_ConvCpltCallback(ADC_HandleTypeDef* hadc)
{
    if (hadc->Instance == ADC1 && !zero_set_flag) {
    	if(__HAL_TIM_GET_COUNTER(&htim3) < 500){
        	//オフセット検出モードか、電流センシングモードか
        	if(offset_done_flag == false){
        		adc_offset[0] += adc_raw[0];
        		adc_offset[1] += adc_raw[1];
        		adc_offset[2] += adc_raw[2];

        		offset_count++;

        		if(offset_count >= offset_ave_num){
    				adc_offset[0] = adc_offset[0] / offset_ave_num;
    				adc_offset[1] = adc_offset[1] / offset_ave_num;
    				adc_offset[2] = adc_offset[2] / offset_ave_num;
        			offset_done_flag = true;
        		}
        	}
        	else{
        		//(3.3 / 4096.0)) / 0.05 = 0.01611
        		I_u = (float)(adc_raw[2] - adc_offset[2]) * 0.01611f;
        		I_v = (float)(adc_raw[1] - adc_offset[1]) * 0.01611f;
        		I_w = (float)(adc_raw[0] - adc_offset[0]) * 0.01611f;
        		I_sum = I_u + I_v + I_w;

				/*	現在のカウントを取得	*/
				cnt_now = __HAL_TIM_GET_COUNTER(&htim2);

				/*	ラジアン角を算出して、ついでに電気角も算出！	*/
				degree = (float)(cnt_now / 20480.0f) * 2.0f * PI;
				degree_e = (float)degree * (float)pole_pairs;
				degree_e_sin = sinf(degree_e);
				degree_e_cos = cosf(degree_e);

				HAL_GPIO_TogglePin(LED_R_GPIO_Port, LED_R_Pin);

				//Iu,Iv,Iw -> Iα,Iβ
				clarke_transform();
				//Iα,Iβ -> Id,Iq
				park_transform();

				//Id,IqをPI制御
				Vd = PI_Control(&Id_PI);
				Vq = PI_Control(&Iq_PI);

				// ★ ログ記録 (10kHzを100Hzに間引いて500件保存)
				if (logging_active && log_index < LOG_SIZE) {
					log_prescaler++;
					if (log_prescaler >= 100) {
						log_prescaler = 0;
						dq_log[0][log_index] = Id;
						dq_log[1][log_index] = Iq;
						log_index++;
					}
				}

				//Vd,Vq -> Vα,Vβ
				inv_park_transform();

				Va = Va * (500.0f / 12.0f);
				Vb = Vb * (500.0f / 12.0f);

				//Vα,Vβ -> Vu,Vv,Vw
				inv_clarke_transform();

				U_PWM = constrain(U_PWM, -Amp_PWM_MAX, Amp_PWM_MAX);
				V_PWM = constrain(V_PWM, -Amp_PWM_MAX, Amp_PWM_MAX);
				W_PWM = constrain(W_PWM, -Amp_PWM_MAX, Amp_PWM_MAX);

				//PWMをセット
				SET_PWM_DUTY(U, 500 + U_PWM);
				SET_PWM_DUTY(V, 500 + V_PWM);
				SET_PWM_DUTY(W, 500 + W_PWM);
        	}
    	}
    }
}

//clarke変換
void clarke_transform(){
	Ia = I_u;
	Ib = (I_u + 2.0f * I_v) * ONE_OVER_SQRT3;
}

//park変換
void park_transform(){
	Id = Ia * degree_e_cos + Ib * degree_e_sin;
	Iq = -Ia * degree_e_sin + Ib * degree_e_cos;

	Id_PI.now_value = Id;
	Iq_PI.now_value = Iq;
}

//逆clarke変換
void inv_clarke_transform(){
	U_PWM = (int)Va;
	V_PWM = (int)((SQRT3_OVER_2 * Vb - Va * 0.5f));
	W_PWM = (int)((-SQRT3_OVER_2 * Vb - Va * 0.5f));
}

//逆park変換
void inv_park_transform(){
	Va = Vd * degree_e_cos - Vq * degree_e_sin;
	Vb = Vd * degree_e_sin + Vq * degree_e_cos;
}

//PI制御
float PI_Control(PI_t *hPI){
	hPI->error = hPI->goal - hPI->now_value;
	hPI->error_integral += hPI->error * hPI->ki;

	// アンチワインドアップ（本体を直接制限する）
	if(hPI->error_integral > hPI->integral_limit){
		hPI->error_integral = hPI->integral_limit;
	}
	else if(hPI->error_integral < -hPI->integral_limit){
		hPI->error_integral = -hPI->integral_limit;
	}

	return (hPI->kp * hPI->error + hPI->error_integral);
}

/* USER CODE END 0 */

/**
  * @brief  The application entry point.
  * @retval int
  */
int main(void)
{

  /* USER CODE BEGIN 1 */
  setbuf(stdout, NULL);
  /* USER CODE END 1 */

  /* MCU Configuration--------------------------------------------------------*/

  /* Reset of all peripherals, Initializes the Flash interface and the Systick. */
  HAL_Init();

  /* Configure the system clock */
  SystemClock_Config();

  /* Initialize all configured peripherals */
  MX_GPIO_Init();
  MX_DMA_Init();
  MX_ADC1_Init();
  MX_TIM3_Init();
  MX_USART1_UART_Init();
  MX_TIM2_Init();
  MX_TIM1_Init();
  /* USER CODE BEGIN 2 */

  /*	前処理スタート	*/

  HAL_Delay(5000);

  //全IR2302をロック(安全のため！)
  HAL_GPIO_WritePin(U_SD_GPIO_Port, U_SD_Pin, RESET);
  HAL_GPIO_WritePin(V_SD_GPIO_Port, V_SD_Pin, RESET);
  HAL_GPIO_WritePin(W_SD_GPIO_Port, W_SD_Pin, RESET);

  //ADCのキャリブレーション
  HAL_ADCEx_Calibration_Start(&hadc1, ADC_SINGLE_ENDED);

  //PWMスタート
  HAL_TIM_PWM_Start(&MOTOR_PWM_TIMER, U_PHASE_PWM_CHANNEL);
  HAL_TIM_PWM_Start(&MOTOR_PWM_TIMER, V_PHASE_PWM_CHANNEL);
  HAL_TIM_PWM_Start(&MOTOR_PWM_TIMER, W_PHASE_PWM_CHANNEL);

  //全IR2302のロックを解除
  HAL_GPIO_WritePin(U_SD_GPIO_Port, U_SD_Pin, SET);
  HAL_GPIO_WritePin(V_SD_GPIO_Port, V_SD_Pin, SET);
  HAL_GPIO_WritePin(W_SD_GPIO_Port, W_SD_Pin, SET);

  //回転を固定
  SET_PWM_DUTY(U, 500);
  SET_PWM_DUTY(V, 500);
  SET_PWM_DUTY(W, 500);

  //ADCをDMAモードで待機！
  if (HAL_ADC_Start_DMA(&hadc1, (uint32_t*)adc_raw, 3) != HAL_OK)
  {
	  Error_Handler();
  }

  while(offset_done_flag == false){
	  //オフセット電圧検出待ち...
  }

  zero_set_flag = true;

  /*	電気角のリセット	*/

  //電流方向U->Vのときを電気角0[rad]と定義
  SET_PWM_DUTY(U, 700);
  SET_PWM_DUTY(V, 500);
  SET_PWM_DUTY(W, 500);

  //固定待ち...
  HAL_Delay(700);

  zero_set_flag = false;

  //0カウントをセット
  __HAL_TIM_SET_COUNTER(&htim2, 0);

  //エンコーダースタート！
  HAL_TIM_Encoder_Start(&htim2, TIM_CHANNEL_ALL);

  //全IR2302のロックを解除
  HAL_GPIO_WritePin(U_SD_GPIO_Port, U_SD_Pin, SET);
  HAL_GPIO_WritePin(V_SD_GPIO_Port, V_SD_Pin, SET);
  HAL_GPIO_WritePin(W_SD_GPIO_Port, W_SD_Pin, SET);

  //回転を固定
  SET_PWM_DUTY(U, 500);
  SET_PWM_DUTY(V, 500);
  SET_PWM_DUTY(W, 500);

  //制御用タイマ割り込みスタート
  HAL_TIM_Base_Start_IT(&htim1);
  __HAL_TIM_ENABLE_IT(&htim3, TIM_IT_UPDATE);
  /*	FOCスタート		*/

  //d軸電流のパラメータを設定
  Id_PI.goal = 0.0f;
  Id_PI.kp = 2.0f;
  Id_PI.ki = 0.7f;
  Id_PI.integral_limit = 10.0f;

  //q軸電流のパラメータを設定
  Iq_PI.goal = 1.0f;
  Iq_PI.kp = 2.0f;
  Iq_PI.ki = 0.7f;
  Iq_PI.integral_limit = 10.0f;

  // ログ記録スタート
	logging_active = true;

	// 5秒間FOCで回す
	HAL_Delay(5000);

	// 5秒経過したら止める（安全のためにIq=0にしてIR2302をシャットダウン）
	logging_active = false;
	Iq_PI.goal = 0.0f;

	HAL_GPIO_WritePin(U_SD_GPIO_Port, U_SD_Pin, RESET);
	HAL_GPIO_WritePin(V_SD_GPIO_Port, V_SD_Pin, RESET);
	HAL_GPIO_WritePin(W_SD_GPIO_Port, W_SD_Pin, RESET);
	SET_PWM_DUTY(U, 0);
	SET_PWM_DUTY(V, 0);
	SET_PWM_DUTY(W, 0);

	// 溜め込んだdq軸電流のログをUARTで一気に吐き出す
	printf("Id, Iq\r\n");
	for(int i = 0; i < LOG_SIZE; i++){
		printf("%f, %f\r\n", dq_log[0][i], dq_log[1][i]);
		HAL_Delay(2); // UARTのバッファ溢れ（文字化け）防止
	}
  /* USER CODE END 2 */

  /* Infinite loop */
  /* USER CODE BEGIN WHILE */
  while (1)
  {
    /* USER CODE END WHILE */

    /* USER CODE BEGIN 3 */

  }
  /* USER CODE END 3 */
}

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
