sirayuri/SPCC_BLDC/programs/Hand_Made_BLDC/Hand_Made_BLDC.ioc

PB6.Signal=S_TIM4_CH1
PB1.GPIO_Label=M1_OPAMP3_OUT
PA8.Signal=S_TIM1_CH1
PA0.Signal=ADC1_IN1
PB1.Signal=SharedAnalog_PB1
PA10.Signal=S_TIM1_CH3
PF1-OSC_OUT.Signal=RCC_OSC_OUT
PC13.Signal=TIM1_CH1N
PA8.GPIO_Label=M1_PWM_UH
PB14.Signal=ADC1_IN5
PA5.Signal=OPAMP2_VINM0
PB4.GPIO_Label=UART_RX
PB15.GPIO_Label=M1_PWM_WL
PA1.GPIO_Label=M1_CURR_SHUNT_U
PA5.GPIO_Label=M1_OPAMP2_INT_GAIN
PA0.GPIO_Label=M1_BUS_VOLTAGE
PB15.Signal=TIM1_CH3N
PB7.Signal=S_TIM4_CH2
PB7.GPIO_Label=M1_ENCODER_B
PA6.Signal=SharedAnalog_PA6
PB4.Signal=USART2_RX
PA3.Signal=OPAMP1_VINM0
PA12.GPIO_Label=M1_PWM_VL
PA13.Signal=SYS_JTMS-SWDIO
PA1.Signal=SharedAnalog_PA1
PB2.GPIO_Label=M1_OPAMP3_INT_GAIN
PA3.GPIO_Label=M1_OPAMP1_INT_GAIN
PB14.GPIO_Label=M1_TEMPERATURE
PA14.GPIO_Label=TCK
PA6.GPIO_Label=M1_OPAMP2_OUT
PB6.GPIO_Label=M1_ENCODER_A
PB2.Signal=OPAMP3_VINM0
PA9.GPIO_Label=M1_PWM_VH
PA9.Signal=S_TIM1_CH2
PF0-OSC_IN.Signal=RCC_OSC_IN
PB0.Signal=SharedAnalog_PB0
Mcu.UserName=STM32G431CBUx
PC10.Signal=GPXTI10
PB0.GPIO_Label=M1_CURR_SHUNT_W
PC13.GPIO_Label=M1_PWM_UL
PA12.Signal=TIM1_CH2N
PA10.GPIO_Label=M1_PWM_WH
PA2.GPIO_Label=M1_OPAMP1_OUT
PB3.GPIO_Label=UART_TX
PC10.GPIO_Label=Start/Stop [PushButton]
PA13.GPIO_Label=TMS
PA2.Signal=SharedAnalog_PA2
PB3.Signal=USART2_TX
PA7.GPIO_Label=M1_CURR_SHUNT_V
PA14.Signal=SYS_JTCK-SWCLK
PA7.Signal=SharedAnalog_PA7
