sirayuri/SPCC_BLDC/(commit log)

2026-02-08 ステータの場所をいどう
2026-02-08 アセンブリまで仕上げた．明日最終確認
2026-02-09 研究背景をいい感じにした
2026-02-09 DXF出した
2026-02-11 texで書き始めた
2026-02-11 章名を列挙
2026-02-11 めっちゃがんんばって進めた
2026-02-12 言い回しの改善
2026-02-12 トルクの理論値まで書いた
2026-02-13 言い回しかえた
2026-02-15 すべていい感じにした
2026-02-16 いい感じにした
2026-02-17 プリンタパーツのstepとか出した
2026-02-17 ステータのカバーつくった
2026-02-18 かばー印刷
2026-02-18 ベアリング追加太郎
2026-02-19 ローター新しくする
2026-02-19 色々印刷
2026-02-21 かばーの寸法変えた
2026-02-23 いろいろプログラム増やした
2026-02-24 ノートPCの環境でプログラム使えるようにした
2026-02-24 ローターのモデルをまともにした
2026-02-25 スペーサーを新しくしたよ
2026-02-25 ベクトル制御かきかき
2026-02-26 メモとか追加
2026-02-26 motor_pilot用のプログラム追加
2026-02-26 なんかcubeIDEのログ
2026-02-27 いい感じにデータ取ったよ
2026-02-27 実験ファイルを追加
2026-03-08 設計をブラッシュアップ
2026-03-08 いろいろデータ＆プログラム追加
