sirayuri/SPCC_BLDC/(notices)

Notices in the files:
programs/SPCC_BLDC_FOC_dq_FF/Core/Src/main.c:
Copyright (c) 2026 STMicroelectronics.
All rights reserved.
This software is licensed under terms that can be found in the LICENSE file
programs/Hand_Made_BLDC/Inc/main.h:
© Copyright (c) 2026 STMicroelectronics.
(C) COPYRIGHT STMicroelectronics *****END OF FILE
